sehun98/QRS-complex-detection-device-using-Pan-Tompkins-Algorithm/Images/figure2.png

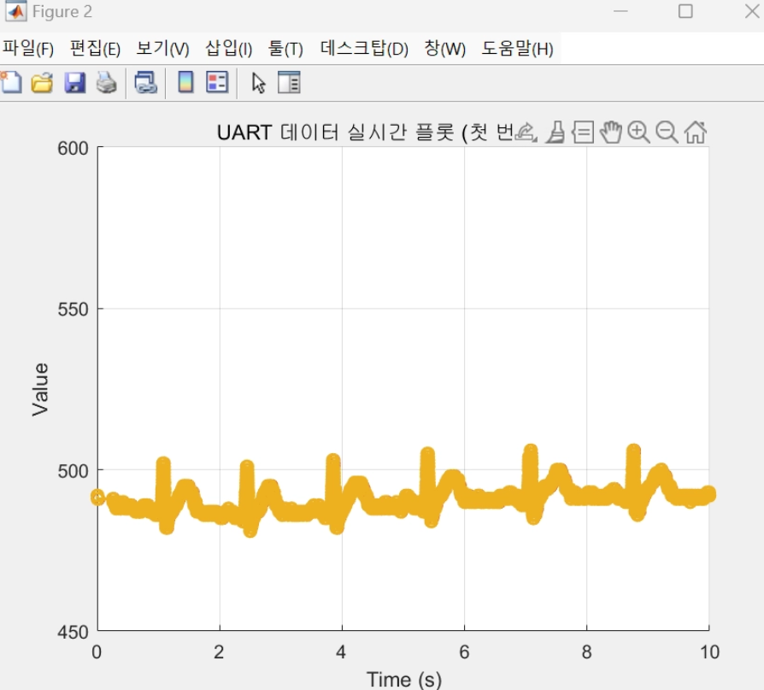
Images/figure2.png
