sehun98/QRS-complex-detection-device-using-Pan-Tompkins-Algorithm/(list of files, drawings)

Other design files:
1. Hardware/ECG/PCB/ECG.pcb
1. Hardware/ECG/PCB/ECG_backup.pcb
1. Hardware/ECG/PCB/ECG_COPPER_backup.pcb
