sehun98/QRS-complex-detection-device-using-Pan-Tompkins-Algorithm/2. Firmware/1. Atmega128A_Uart/1. Atmega128A_Uart/uart.c

/***************************************************************************************************
                                   ExploreEmbedded  
 ****************************************************************************************************
 * File:   uart.c (AVR controllers)
 * Version: 16.0
 * Author: ExploreEmbedded
 * Website: http://www.exploreembedded.com/wiki
 * Description: File contains the Library routines for UART

The libraries have been tested on ExploreEmbedded development boards. We strongly believe that the 
library works on any of development boards for respective controllers. However, ExploreEmbedded 
disclaims any kind of hardware failure resulting out of usage of libraries, directly or indirectly.
Files may be subject to change without prior notice. The revision history contains the information 
related to updates. 


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
Errors and omissions should be reported to codelibraries@exploreembedded.com
 **************************************************************************************************/


/**************************************************************************************************
                             Revision History
 ****************************************************************************************************
15.0: Initial version 
16.0: Updated the Tx Number function to support bin,dec,hex in one function.
 ***************************************************************************************************/
#include <stdarg.h>
#include "uart.h"






/***************************************************************************************************
                    void UART_Init(uint8_t v_uartChannel_u8, uint32_t v_baudRate_u32)
 ****************************************************************************************************
 * I/P Arguments: uint32_t : Baudrate to be configured.
 * Return value    : none

 * description  :This function is used to initialize the UART at specified baud rate.
                 If the requested baud rate is not within the supported range then
                 the default baud rate of 9600 is set.


            Refer uart.h file for Supported(range) baud rates.        
 ***************************************************************************************************/
void UART_Init(uint8_t v_uartChannel_u8, uint32_t v_baudRate_u32)
{
    if(v_uartChannel_u8 == C_UartZero_U8)
    {
        UCSR0B= (1<<RXEN0) | (1<<TXEN0);                  // Enable Receiver and Transmitter
        UCSR0C= (1<<UCSZ01) | (1<<UCSZ00);                // Asynchronous mode 8-bit data and 1-stop bit
        UCSR0A= 0x00;                                   // Clear the UASRT status register
        UART_SetBaudRate(C_UartZero_U8,v_baudRate_u32);
    }
    else if(v_uartChannel_u8 == C_UartOne_U8)
    {
        UCSR1B= (1<<RXEN1) | (1<<TXEN1);                  // Enable Receiver and Transmitter
        UCSR1C= (1<<UCSZ11) | (1<<UCSZ10);                // Asynchronous mode 8-bit data and 1-stop bit
        UCSR1A= 0x00;                                   // Clear the UASRT status register
        UART_SetBaudRate(C_UartOne_U8,v_baudRate_u32);
    }
}






/***************************************************************************************************
                 void UART_SetBaudRate(uint8_t v_uartChannel_u8, uint32_t v_baudRate_u32)
 ***************************************************************************************************
 * I/P Arguments: uint32_t : v_baudRate_u32 to be configured.
 * Return value    : none

 * description  :This function is used to Set/Change the baudrate on the fly.
                 If the requested baud rate is not within the supported range then
                 the default baudrate of 9600 is set.

            Refer uart.h file for Supported range of baud rates.
 ***************************************************************************************************/
void UART_SetBaudRate(uint8_t v_uartChannel_u8, uint32_t v_baudRate_u32)
{
    uint16_t RegValue;

    if((v_baudRate_u32 >= C_MinBaudRate_U32) && (v_baudRate_u32<=C_MaxBaudRate_U32))
    {
        /* Check if the requested baudate is within range,
         If yes then calculate the value to be loaded into baud rate generator. */
        RegValue = M_GetBaudRateGeneratorValue(v_baudRate_u32);
    }
    else
    {
        /*   Invalid baudrate requested, hence set it to default baudrate of 9600 */
        RegValue = M_GetBaudRateGeneratorValue(9600);
    }

    if(v_uartChannel_u8 == C_UartZero_U8)
    {
        UBRR0L = util_ExtractByte0to8(RegValue);
        UBRR0H = util_ExtractByte8to16(RegValue);
    }
    else if(v_uartChannel_u8 == C_UartOne_U8)
    {
        UBRR1L = util_ExtractByte0to8(RegValue);
        UBRR1H = util_ExtractByte8to16(RegValue);
    }
}





/***************************************************************************************************
                    char UART_RxChar(uint8_t v_uartChannel_u8)
 ***************************************************************************************************
 * I/P Arguments: none.
 * Return value    : char: Ascii value of the character received

 * description :This function is used to receive a char from UART module.
                It waits till a char is received and returns it after reception.
 ***************************************************************************************************/
char UART_RxChar(uint8_t var_uartChannel_u8)
{
	char ch = 0;

	switch(var_uartChannel_u8)
	{
		case 0:
		while(util_IsBitCleared(UCSR0A,RXC0));  // Wait till the data is received
		ch = UDR0;

		break;


		case 1:
		while(util_IsBitCleared(UCSR1A,RXC1));  // Wait till the data is received
		ch = UDR1;
		break;

	}
	return ch;
}








/***************************************************************************************************
                         void UART_TxChar(char v_uartData_u8)
 ****************************************************************************************************
 * I/P Arguments: char--> Ascii value of the character to be transmitted.
 * Return value    : none.

 * description  :This function is used to transmit a char through UART module.
 ***************************************************************************************************/
void UART_TxChar(uint8_t v_uartChannel_u8, char v_uartData_u8)
{
    if(v_uartChannel_u8 == C_UartZero_U8)
    {
        while(util_IsBitCleared(UCSR0A,UDRE0)); // Wait till Transmitter(UDR) register becomes Empty
        UDR0 =v_uartData_u8;
    }
    else if(v_uartChannel_u8 == C_UartOne_U8)
    {
        while(util_IsBitCleared(UCSR1A,UDRE1)); // Wait till Transmitter(UDR) register becomes Empty
        UDR1 =v_uartData_u8; 
    }
}







/***************************************************************************************************
                         void UART_TxString(char *ptr_stringPointer_u8)
 ****************************************************************************************************
 * I/P Arguments: String(Address of the string) to be transmitted.
 * Return value    : none

 * description :This function is used to transmit a NULL terminated string through UART.
               1.The ptr_stringPointer_u8 points to the first char of the string
                    and traverses till the end(NULL CHAR) and transmits a char each time
 ***************************************************************************************************/
#if ((Enable_UART_TxString==1)|| (Enable_UART_Printf == 1))
void UART_TxString(uint8_t v_uartChannel_u8, char *ptr_stringPointer_u8)
{
    while(*ptr_stringPointer_u8)
        UART_TxChar(v_uartChannel_u8, *ptr_stringPointer_u8++);// Loop through the string and transmit char by char
}
#endif






/***************************************************************************************************
                         uint8_t UART_RxString(uint8_t v_uartChannel_u8, char *ptr_string)
 ****************************************************************************************************
 * I/P Arguments: char *:  Address of the string/buffer where the received data needs to be stored
 * Return value : uint8_t: Number of chars received.

 * description  :
              1.This function is used to receive a ASCII string through UART till the carriage_return/New_line
              2.The stream of data is copied to the buffer till carriage_return/New_line is encountered.
              3. Once the Carriage_return/New_Line is received the string will be null terminated.

 *****NOTE*******:
  1.The received char is ECHOED back,
    if not required then comment UART_TxChar(ch) in the code.
  2.BackSlash is not taken care.
 ***************************************************************************************************/
#if (Enable_UART_RxString==1)
uint8_t UART_RxString(uint8_t v_uartChannel_u8, char *ptr_string)
{
    char ch;
    uint8_t len = 0;
    while(1)
    {
        ch=UART_RxChar(v_uartChannel_u8);    //Receive a char
        UART_TxChar(v_uartChannel_u8,ch);     //Echo back the received char

        if((ch=='\r') || (ch=='\n')) //read till enter key is pressed
        {   
            if(len!=0)         /* Wait till atleast 1 char is received */              
            { 
                ptr_string[len]=0;           //once enter key is pressed null terminate the string and break the loop            
                break;  
            }                   
        }
        else if((ch=='\b') && (len!=0))
        {
            len--;    //If backspace is pressed then decrement the index to remove the old char
        }
        else
        {
            ptr_string[len]=ch; //copy the char into string and increment the index
            len++;
        }
    }
    return len;   
}
#endif






/***************************************************************************************************
void UART_TxNumber(uint8_t v_numericSystem_u8, uint32_t v_number_u32, uint8_t v_numOfDigitsToTransmit_u8)
 ***************************************************************************************************
 * I/P Arguments: 
                  uint8_t :  specifies type of number C_BINARY_U8(2),C_DECIMAL_U8(10), C_HEX_U8(16)
                  uint32_t: Number to be transmitted on UART.
                  uint8_t : Number of digits to be transmitted

 * Return value    : none

 * description  :This function is used to transmit a max of 10digit decimal number.
                2nd parameter specifies the number of digits from the right side to be transmitted
                 The output for the input combinations is as below

    Binary:     1.(10,4) then 4-LSB will be transmitted ie. 1010
                2.(10,8) then 8-LSB will be transmitted ie. 00001010
                3.(10,2) then 2-LSB will be transmitted ie. 10     

    Decimal            
                4.(12345,4) then 4-digits ie. 2345 will be transmitted
                5.(12345,6) then 6-digits ie. 012345 will be transmitted
                6.(12345,C_DefaultDigitsToTransmit_U8) then 12345 will be transmitted.

    Hex:
                7.(0x12AB,3) then 3-digits ie. 2AB will be transmitted
                8.(0x12AB,6) then 6-digits ie. 0012AB will be transmitted
                9.(0x12AB,C_DefaultDigitsToTransmit_U8) then 12AB will be transmitted.    
 ***************************************************************************************************/
#if ((Enable_UART_TxNumber==1) || (Enable_UART_TxFloatNumber==1) || (Enable_UART_Printf == 1))
void UART_TxNumber(uint8_t v_uartChannel_u8, uint8_t v_numericSystem_u8, uint32_t v_number_u32, uint8_t v_numOfDigitsToTransmit_u8)
{
    uint8_t i=0,a[10];

    if(C_BINARY_U8 == v_numericSystem_u8)
    {
        while(v_numOfDigitsToTransmit_u8!=0)
        {
            /* Start Extracting the bits from the specified bit positions.
             Get the Acsii values of the bits and transmit */
            i = util_GetBitStatus(v_number_u32,(v_numOfDigitsToTransmit_u8-1));
            UART_TxChar(v_uartChannel_u8,util_Dec2Ascii(i));
            v_numOfDigitsToTransmit_u8--;
        }    
    }     
    else if(v_number_u32==0)
    {
        /* If the number is zero then Transmit Specified number of zeros*/
        /*TODO: trsnamit single zero or multiple, Currently single zero is transmitted*/
        // for(i=0;((i<v_numOfDigitsToTransmit_u8) && (i<C_MaxDigitsToTransmit_U8)) ;i++)
        UART_TxChar(v_uartChannel_u8,'0');
    }
    else
    {
        for(i=0;i<v_numOfDigitsToTransmit_u8;i++)
        {
            /* Continue extracting the digits from right side
               till the Specified v_numOfDigitsToTransmit_u8 */
            if(v_number_u32!=0)
            {
                /* Extract the digits from the number till it becomes zero.
                First get the remainder and divide the number by 10 each time.

                example for Decimal number:
                If v_number_u32 = 123 then extracted remainder will be 3 and number will be 12.
                The process continues till it becomes zero or max digits reached*/
                a[i]=util_GetMod32(v_number_u32,v_numericSystem_u8);
                v_number_u32=v_number_u32/v_numericSystem_u8;
            }
            else if( (v_numOfDigitsToTransmit_u8 == C_DefaultDigitsToTransmit_U8) ||
                    (v_numOfDigitsToTransmit_u8 > C_MaxDigitsToTransmit_U8))
            {
                /* Stop the iteration if the Max number of digits are reached or
                 the user expects exact(Default) digits in the number to be transmitted */ 
                break;
            }
            else
            {
                /*In case user expects more digits to be transmitted than the actual digits in number,
                  then update the remaining digits with zero.
                Ex: v_number_u32 is 123 and user wants five digits then 00123 has to be transmitted */
                a[i]=0;
            }
        }

        while(i)
        { 
            /* Finally get the ascii values of the digits and transmit*/
            UART_TxChar(v_uartChannel_u8,util_Hex2Ascii(a[i-1]));
            i--;
        }
    }


}
#endif









/***************************************************************************************************
            void  UART_TxFloatNumber(float v_floatNumber_f32)
 ***************************************************************************************************
 * Function name:  UART_TxFloatNumber()
 * I/P Arguments: float: float Number to be transmitted on UART.

 * Return value    : none

 * description  :This function is used to transmit a floating point number

 * Note         :It supports 6digits of precision.  
         Float will be disabled by default as it takes huge controller resources
         It can be enabled by changing value of Enable_UART_TxFloatNumber to 1 in uart.h     
 ***************************************************************************************************/
#if (Enable_UART_TxFloatNumber==1)
void UART_TxFloatNumber(uint8_t v_uartChannel_u8, float v_floatNumber_f32)
{
    uint32_t v_tempNumber_u32;
    /* Dirty hack to support the floating point by extracting the integer and fractional part.
      1.Type cast the number to int to get the integer part.
      2.transmit the extracted integer part followed by a decimal point(.).
      3.Later the integer part is made zero by subtracting with the extracted integer value.
      4.Finally the fractional part is multiplied by 100000 to support 6-digit precision */

    v_tempNumber_u32 = (uint32_t) v_floatNumber_f32;
    UART_TxNumber(v_uartChannel_u8,C_DECIMAL_U8,v_tempNumber_u32,C_DefaultDigitsToTransmit_U8);

    UART_TxChar(v_uartChannel_u8,'.');

    v_floatNumber_f32 = v_floatNumber_f32 - v_tempNumber_u32;
    v_tempNumber_u32 = v_floatNumber_f32 * 1000000;
    UART_TxNumber(v_uartChannel_u8,C_DECIMAL_U8,v_tempNumber_u32,C_DefaultDigitsToTransmit_U8);
}
#endif






/***************************************************************************************************
            void UART_Printf(const char *argList, ...)
 ***************************************************************************************************
 * Function name:  UART_Printf()
 * I/P Arguments: variable length arguments similar to printf

 * Return value    : none

 * description  :This function is similar to printf function in C.
                 It takes the arguments with specified format and prints accordingly
                 The supported format specifiers are as below.
                 1. %c: character
                 2. %d: signed 16-bit number
                 3. %D: signed 32-bit number
                 4. %u: unsigned 16-bit number
                 5. %U: unsigned 32-bit number
                 6. %b: 16-bit binary number
                 7. %B: 32-bit binary number
                 8. %f: Float number
                 9. %x: 16-bit hexadecimal number
                 10. %X: 32-bit hexadecimal number
                 11. %s: String

  Note: By default all the functions will be disabled. The required functions can be enabled by 
        setting the respective compiler switch to 1 in uart.h file.
        Ex:  setting Enable_UART_TxDecimalNumber to 1 will enable %d
             setting Enable_UART_TxHexNumber to 1 will enable %x

  Extra feature is available to specify the number of digits to be transmitted using printf.
     ex: %4d: will transmit the lower four digits of the decimal number.
         %12b: will transmit the 12-LSB of the number
         %d: Will transmit the exact digits of the number

#####: In case of printing the variables(8-bit) its recommended to type cast and promote them to uint16_t.
        uint8_t v_Num_u8;
        UART_Printf("num1:%u",(uint16_t)v_Num_u8);       
 ***************************************************************************************************/
#if ( Enable_UART_Printf   == 1 ) 
void UART_Printf(uint8_t v_uartChannel_u8, const char *argList, ...)
{
    const char *ptr;
    va_list argp;
    sint16_t v_num_s16;
    sint32_t v_num_s32;
    uint16_t v_num_u16;
    uint32_t v_num_u32;
    char *str;
    char  ch;
    uint8_t v_numOfDigitsToTransmit_u8;
#if (Enable_UART_TxFloatNumber==1)
    double v_floatNum_f32;
#endif  


    va_start(argp, argList);

    /* Loop through the list to extract all the input arguments */
    for(ptr = argList; *ptr != '\0'; ptr++)
    {

        ch= *ptr;
        if(ch == '%')         /*Check for '%' as there will be format specifier after it */
        {
            ptr++;
            ch = *ptr;
            if((ch>=0x30) && (ch<=0x39))
            {
                v_numOfDigitsToTransmit_u8 = 0;
                while((ch>=0x30) && (ch<=0x39))
                {
                    v_numOfDigitsToTransmit_u8 = (v_numOfDigitsToTransmit_u8 * 10) + (ch-0x30);
                    ptr++;
                    ch = *ptr;
                }
            }
            else
            {
                v_numOfDigitsToTransmit_u8 = C_MaxDigitsToTransmitUsingPrintf_U8;
            }               


            switch(ch)       /* Decode the type of the argument */
            {
            case 'C':
            case 'c':     /* Argument type is of char, hence read char data from the argp */
                ch = va_arg(argp, int);
                UART_TxChar(v_uartChannel_u8,ch);
                break;

            case 'd':    /* Argument type is of signed integer, hence read 16bit data from the argp */
                v_num_s16 = va_arg(argp, sint16_t);
#if (Enable_UART_TxNumber == 1)
                if(v_num_s16<0)
                { /* If the number is -ve then display the 2's complement along with '-' sign */ 
                    v_num_s16 = -v_num_s16;
                    UART_TxChar(v_uartChannel_u8,'-');
                }
                UART_TxNumber(v_uartChannel_u8,C_DECIMAL_U8,v_num_s16,v_numOfDigitsToTransmit_u8);
#endif
                break;

            case 'D':    /* Argument type is of integer, hence read 16bit data from the argp */
                v_num_s32 = va_arg(argp, sint32_t);             
#if (Enable_UART_TxNumber == 1)                
                if(v_num_s32<0)
                { /* If the number is -ve then display the 2's complement along with '-' sign */
                    v_num_s32 = -v_num_s32;
                    UART_TxChar(v_uartChannel_u8,'-');
                }
                UART_TxNumber(v_uartChannel_u8,C_DECIMAL_U8,v_num_s32,v_numOfDigitsToTransmit_u8);
#endif                
                break;    

            case 'u':    /* Argument type is of unsigned integer, hence read 16bit unsigned data */
                v_num_u16 = va_arg(argp, uint16_t);         
#if (Enable_UART_TxNumber == 1)                
                UART_TxNumber(v_uartChannel_u8,C_DECIMAL_U8,v_num_u16,v_numOfDigitsToTransmit_u8);
#endif                
                break;

            case 'U':    /* Argument type is of integer, hence read 32bit unsigend data */
                v_num_u32 = va_arg(argp, uint32_t);         
#if (Enable_UART_TxNumber == 1)                
                UART_TxNumber(v_uartChannel_u8,C_DECIMAL_U8,v_num_u32,v_numOfDigitsToTransmit_u8);
#endif                
                break;            

            case 'x':  /* Argument type is of hex, hence hexadecimal data from the argp */
                v_num_u16 = va_arg(argp, uint16_t);             
#if (Enable_UART_TxNumber == 1)                
                UART_TxNumber(v_uartChannel_u8,C_HEX_U8, v_num_u16,v_numOfDigitsToTransmit_u8);
#endif                
                break;

            case 'X':  /* Argument type is of hex, hence hexadecimal data from the argp */
                v_num_u32 = va_arg(argp, uint32_t);                     
#if (Enable_UART_TxNumber == 1)                        
                UART_TxNumber(v_uartChannel_u8,C_HEX_U8, v_num_u32,v_numOfDigitsToTransmit_u8);
#endif                
                break;


            case 'b':  /* Argument type is of binary,Read int and convert to binary */
                v_num_u16 = va_arg(argp, uint16_t);     
#if (Enable_UART_TxNumber == 1)                        
                if(v_numOfDigitsToTransmit_u8 == C_MaxDigitsToTransmitUsingPrintf_U8)
                {
                    v_numOfDigitsToTransmit_u8 = 16;
                }
                UART_TxNumber(v_uartChannel_u8,C_BINARY_U8, v_num_u16,v_numOfDigitsToTransmit_u8);
#endif                
                break;

            case 'B':  /* Argument type is of binary,Read int and convert to binary */
                v_num_u32 = va_arg(argp, uint32_t);         
#if (Enable_UART_TxNumber == 1)                
                if(v_numOfDigitsToTransmit_u8 == C_MaxDigitsToTransmitUsingPrintf_U8)
                    v_numOfDigitsToTransmit_u8 = 16;                
                UART_TxNumber(v_uartChannel_u8,C_BINARY_U8, v_num_u32,v_numOfDigitsToTransmit_u8);    
#endif                
                break;


            case 'F':
            case 'f': /* Argument type is of float, hence read double data from the argp */
#if (Enable_UART_TxFloatNumber==1)              
                v_floatNum_f32 = va_arg(argp, double);              
                UART_TxFloatNumber(v_uartChannel_u8, v_floatNum_f32);
#endif            
                break;                


            case 'S':
            case 's': /* Argument type is of string, hence get the pointer to sting passed */
                str = va_arg(argp, char *);
                UART_TxString(v_uartChannel_u8,str);                
                break;

            case '%':
                UART_TxChar(v_uartChannel_u8,'%');
                break;
            }
        }
        else
        {
            /* As '%' is not detected transmit the char passed */
            UART_TxChar(v_uartChannel_u8,ch);
        }
    }

    va_end(argp);
}
#endif
