sehun98/QRS-complex-detection-device-using-Pan-Tompkins-Algorithm/2. Firmware/1. Atmega128A_Uart/1. Atmega128A_Uart/uart.h

/***************************************************************************************************
                                   ExploreEmbedded  
 ****************************************************************************************************
 * File:   uart.h
 * Version: 15.0
 * Author: ExploreEmbedded
 * Website: http://www.exploreembedded.com/wiki
 * Description: Contains the baudrate configurations and function prototypes for UART routines

The libraries have been tested on ExploreEmbedded development boards. We strongly believe that the 
library works on any of development boards for respective controllers. However, ExploreEmbedded 
disclaims any kind of hardware failure resulting out of usage of libraries, directly or indirectly.
Files may be subject to change without prior notice. The revision history contains the information 
related to updates. 


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
Errors and omissions should be reported to codelibraries@exploreembedded.com
 **************************************************************************************************/



/***************************************************************************************************
                             Revision History
 ****************************************************************************************************
15.0: Initial version 
 ***************************************************************************************************/
#ifndef _UART_H_
#define _UART_H_

#include <avr/io.h>
#include "stdutils.h"



/***************************************************************************************************
                             Baudrate configurations
 ***************************************************************************************************/
#define C_MinBaudRate_U32 2400
#define C_MaxBaudRate_U32 115200UL


#define M_GetBaudRateGeneratorValue(baudrate)  (((F_CPU -((baudrate) * 8L)) / ((baudrate) * 16UL)))
/**************************************************************************************************/





/***************************************************************************************************
                           UART channel configuration
 ***************************************************************************************************/                 

#define C_UartZero_U8    0u
#define C_UartOne_U8     1u
/**************************************************************************************************/





/***************************************************************************************************
                      PreCompile configurations to enable/disable the functions
 ****************************************************************************************************
PreCompile configuration to enable or disable the API's.
 1.Required interfaces can be enabled/disabled by configuring 
   its respective macros to 1/0.
 2. By default all the API's are enabled except for FLOAT transmission.
 3. Transmitting of floating number takes huge controller
    resources and need to be enabled only if required. 
    This implies for other interfaces as well. 
 ***************************************************************************************************/
#define    Enable_UART_TxString          1
#define    Enable_UART_RxString          1
#define    Enable_UART_TxNumber          1
#define    Enable_UART_TxFloatNumber     1
#define    Enable_UART_Printf            1
/**************************************************************************************************/





/***************************************************************************************************
                             Commonly used UART macros/Constants
 ***************************************************************************************************/
#define C_DefaultDigitsToTransmit_U8          0xffu    // Will transmit the exact digits in the number
#define C_MaxDigitsToTransmit_U8              10u      // Max decimal/hexadecimal digits to be transmitted
#define C_NumOfBinDigitsToTransmit_U8         16u      // Max bits of a binary number to be transmitted
#define C_MaxDigitsToTransmitUsingPrintf_U8   C_DefaultDigitsToTransmit_U8 /* Max dec/hexadecimal digits to be displayed using printf */
/**************************************************************************************************/





/***************************************************************************************************
                             Function Prototypes
 ***************************************************************************************************/
void UART_Init(uint8_t var_uartChannel_u8, uint32_t var_baudRate_u32);
void UART_SetBaudRate(uint8_t var_uartChannel_u8, uint32_t var_baudRate_u32);
void UART_TxChar(uint8_t var_uartChannel_u8, char var_uartData_u8);
char UART_RxChar(uint8_t var_uartChannel_u8);
void UART_TxString(uint8_t var_uartChannel_u8, char *ptr_stringPointer_u8);
uint8_t UART_RxString(uint8_t var_uartChannel_u8, char *ptr_string);
void UART_TxNumber(uint8_t var_uartChannel_u8, uint8_t var_numericSystem_u8, uint32_t var_number_u32, uint8_t var_numOfDigitsToTransmit_u8);
void UART_TxFloatNumber(uint8_t var_uartChannel_u8, float var_floatNumber_f32);
void UART_Printf(uint8_t var_uartChannel_u8, const char *argList, ...);
/**************************************************************************************************/





/****************************************************************************************************
                           Function Mapping To Support Muliple Channels
 *****************************************************************************************************/
#define UART0_Init(baudrate) UART_Init(C_UartZero_U8,  baudrate)
#define UART1_Init(baudrate) UART_Init(C_UartOne_U8,   baudrate)

#define UART0_TxChar(ch) UART_TxChar(C_UartZero_U8,  ch)
#define UART1_TxChar(ch) UART_TxChar(C_UartOne_U8,   ch)

#define UART0_RxChar() UART_RxChar(C_UartZero_U8)
#define UART1_RxChar() UART_RxChar(C_UartOne_U8)

#define UART0_TxString(ptr) UART_TxString(C_UartZero_U8,  ptr)
#define UART1_TxString(ptr) UART_TxString(C_UartOne_U8,   ptr)

#define UART0_RxString(ptr) UART_RxString(C_UartZero_U8,  ptr)
#define UART1_RxString(ptr) UART_RxString(C_UartOne_U8,   ptr)

#define UART0_TxNumber(NumberSystem, Number, NoOfDigits)  UART_TxNumber(C_UartZero_U8,  NumberSystem, Number, NoOfDigits)
#define UART1_TxNumber(NumberSystem, Number, NoOfDigits)  UART_TxNumber(C_UartOne_U8,   NumberSystem, Number, NoOfDigits)

#define UART0_TxFloatNumber(Number)  UART_TxFloatNumber(C_UartZero_U8,  Number)
#define UART1_TxFloatNumber(Number)  UART_TxFloatNumber(C_UartOne_U8,   Number)

#define UART0_Printf(var_arg_list...) UART_Printf(C_UartZero_U8,  var_arg_list)
#define UART1_Printf(var_arg_list...) UART_Printf(C_UartOne_U8,   var_arg_list)
/****************************************************************************************************/
#endif
