sehun98/QRS-complex-detection-device-using-Pan-Tompkins-Algorithm/(notices)

Notices in the files:
2. Firmware/2. Atmega128A_ECG/2. Atmega128A_ECG/uart.c:
GNU GENERAL PUBLIC LICENSE:
This program is free software: you can redistribute it and/or modify
it under the terms of the GNU General Public License as published by
the Free Software Foundation, either version 3 of the License, or
(at your option) any later version.
